Commotari/vic2020_V2/vic2020mainboard/Address_Selection.kicad_sch

## KiCad design vic2020mainboard/Address_Selection.kicad_sch (2026-04-03)

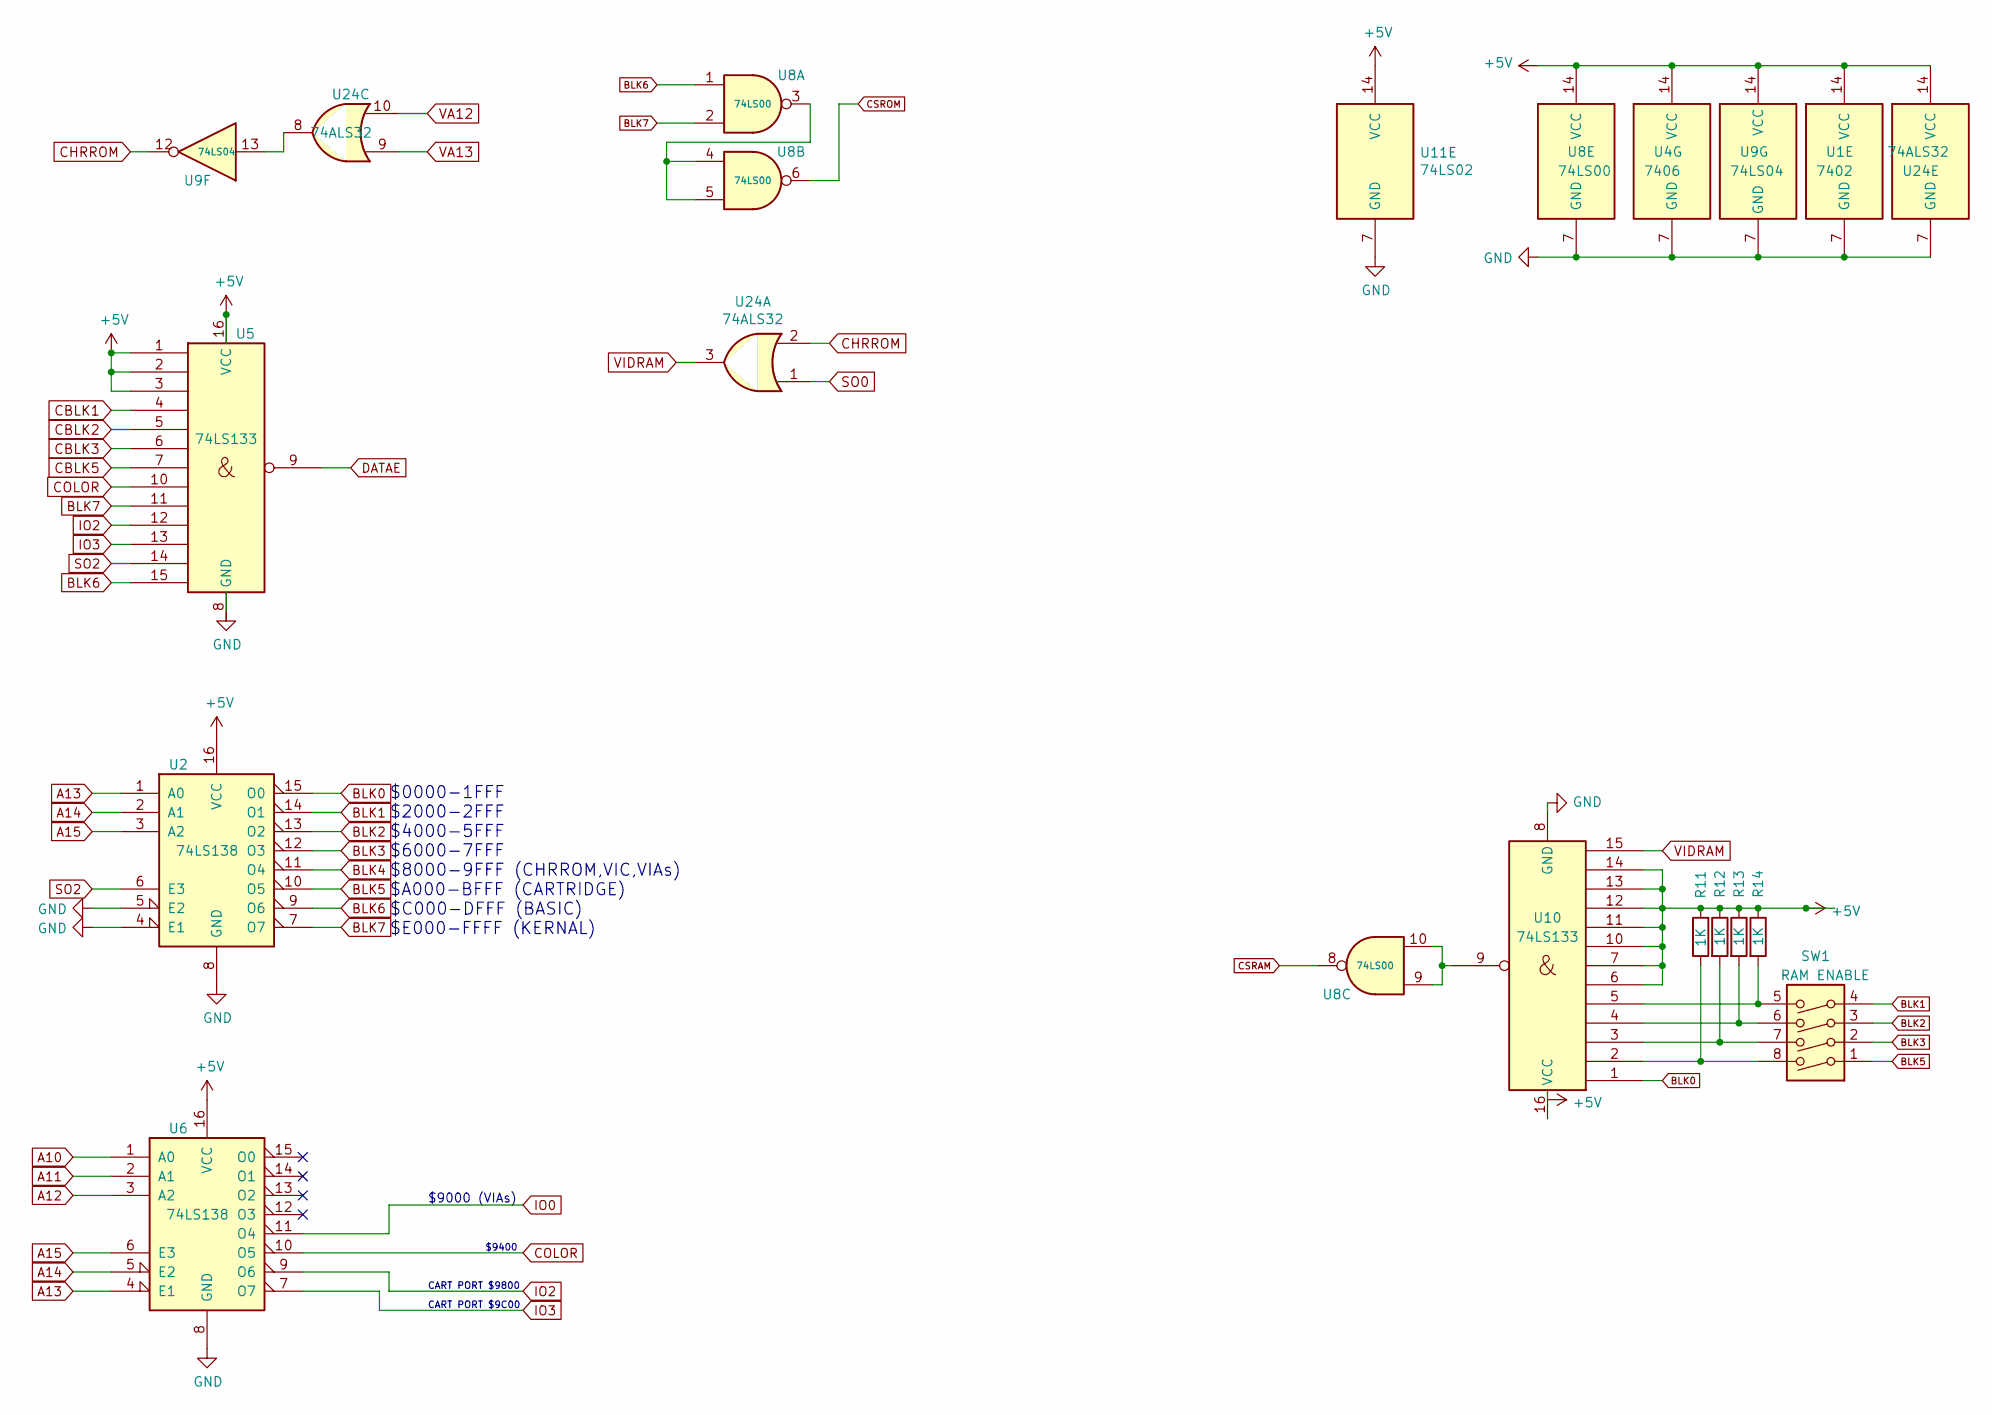
[picture p1: schematic Address_Selection.kicad_sch]

Parts:
R11, R12, R13, R14: 1K; R_Axial_DIN0207_L6.3mm_D2.5mm_P7.62mm_Horizontal
SW1: RAM ENABLE; DIP-8_W7.62mm
U1: 7402; DIP-14_W7.62mm_Socket
U2, U6: 74LS138; DIP-16_W7.62mm_Socket
U4: 7406; DIP-14_W7.62mm_Socket
U5, U10: 74LS133; DIP-16_W7.62mm_Socket
U8: 74LS00; DIP-14_W7.62mm_Socket
U9: 74LS04; DIP-14_W7.62mm_Socket
U11: 74LS02; DIP-14_W7.62mm_Socket
U24: 74ALS32; DIP-14_W7.62mm_Socket

Connections:
+5V: R11.2, R12.1, R13.1, R14.1, U1.14 (VCC), U2.16 (VCC), U4.14 (VCC), U5.1, U5.2, U5.3, U5.16 (VCC), U6.16 (VCC), U8.14 (VCC), U9.14 (VCC), U10.6, U10.7, U10.10, U10.11, U10.12, U10.13, U10.14, U11.14 (VCC), U24.14 (VCC)
A10: U6.1 (A0)
A11: U6.2 (A1)
A12: U6.3 (A2)
A13: U2.1 (A0), U6.4 (E1)
A14: U2.2 (A1), U6.5 (E2)
A15: U2.3 (A2), U6.6 (E3)
BLK0: U2.15 (O0), U10.1
BLK1: SW1.4, U2.14 (O1)
BLK2: SW1.3, U2.13 (O2)
BLK3: SW1.2, U2.12 (O3)
BLK4: U2.11 (O4)
BLK5: SW1.1, U2.10 (O5)
BLK6: U2.9 (O6), U5.15, U8.1
BLK7: U2.7 (O7), U5.11, U8.2
CBLK1: U5.4
CBLK2: U5.5
CBLK3: U5.6
CBLK5: U5.7
CHRROM: U9.12, U24.2
COLOR: U5.10, U6.10 (O5)
CSRAM: U8.8
CSROM: U8.6
DATAE: U5.9
GND: U1.7 (GND), U2.4 (E1), U2.5 (E2), U2.8 (GND), U4.7 (GND), U6.8 (GND), U8.7 (GND), U9.7 (GND), U10.8 (GND), U11.7 (GND), U24.7 (GND)
IO0: U6.11 (O4)
IO2: U5.12, U6.9 (O6)
IO3: U5.13, U6.7 (O7)
unnamed: R11.1, SW1.8, U10.2
unnamed: R12.2, SW1.7, U10.3
unnamed: R13.2, SW1.6, U10.4
unnamed: R14.2, SW1.5, U10.5
unnamed: U8.3, U8.4, U8.5
unnamed: U8.9, U8.10, U10.9
unnamed: U9.13, U24.8
SO0: U24.1
SO2: U2.6 (E3), U5.14
VA12: U24.10
VA13: U24.9
VIDRAM: U10.15, U24.3

Notes on the sheet:
$0000-1FFF $2000-2FFF $4000-5FFF $6000-7FFF $8000-9FFF (CHRROM,VIC,VIAs) $A000-BFFF (CARTRIDGE) $C000-DFFF (BASIC) $E000-FFFF (KERNAL)
CART PORT $9800
CART PORT $9C00
$9400
$9000 (VIAs)
