Commotari/vic2020_V2/vic2020mainboard/Memory.kicad_sch

## KiCad design vic2020mainboard/Memory.kicad_sch (2026-04-03)

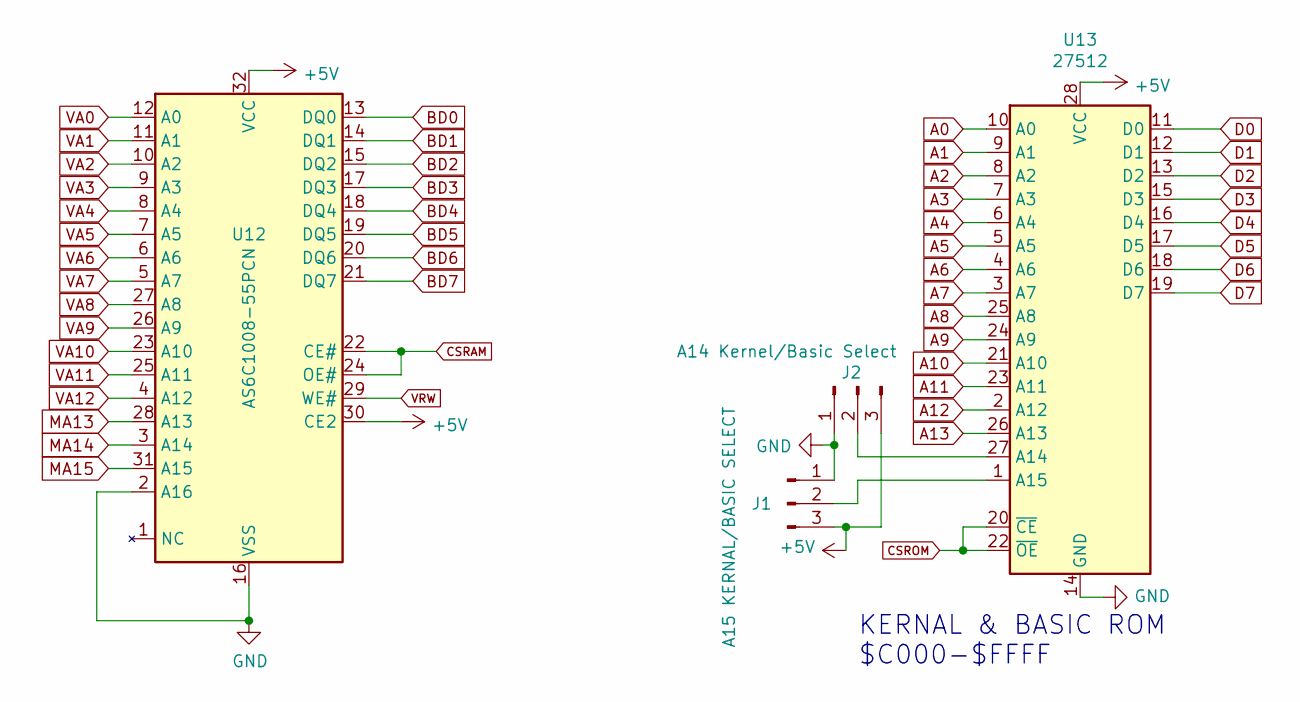
[picture p2: schematic Memory.kicad_sch]

Parts:
J1: A15 KERNAL/BASIC SELECT; PinHeader_1x03_P2.54mm_Vertical
J2: A14 Kernel/Basic Select; PinHeader_1x03_P2.54mm_Vertical
U12: AS6C1008-55PCN; DIP-32_W15.24mm
U13: 27512; DIP-28_W15.24mm

Connections:
+5V: J1.3, J2.3, U12.30 (CE2), U12.32 (VCC), U13.28 (VCC)
A0: U13.10 (A0)
A1: U13.9 (A1)
A2: U13.8 (A2)
A3: U13.7 (A3)
A4: U13.6 (A4)
A5: U13.5 (A5)
A6: U13.4 (A6)
A7: U13.3 (A7)
A8: U13.25 (A8)
A9: U13.24 (A9)
A10: U13.21 (A10)
A11: U13.23 (A11)
A12: U13.2 (A12)
A13: U13.26 (A13)
BD0: U12.13 (DQ0)
BD1: U12.14 (DQ1)
BD2: U12.15 (DQ2)
BD3: U12.17 (DQ3)
BD4: U12.18 (DQ4)
BD5: U12.19 (DQ5)
BD6: U12.20 (DQ6)
BD7: U12.21 (DQ7)
CSRAM: U12.22 (CE#), U12.24 (OE#)
CSROM: U13.20 (~CE), U13.22 (~OE)
D0: U13.11 (D0)
D1: U13.12 (D1)
D2: U13.13 (D2)
D3: U13.15 (D3)
D4: U13.16 (D4)
D5: U13.17 (D5)
D6: U13.18 (D6)
D7: U13.19 (D7)
GND: J1.1, J2.1, U12.2 (A16), U12.16 (VSS), U13.14 (GND)
MA13: U12.28 (A13)
MA14: U12.3 (A14)
MA15: U12.31 (A15)
unnamed: J1.2, U13.1 (A15)
unnamed: J2.2, U13.27 (A14)
VA0: U12.12 (A0)
VA1: U12.11 (A1)
VA2: U12.10 (A2)
VA3: U12.9 (A3)
VA4: U12.8 (A4)
VA5: U12.7 (A5)
VA6: U12.6 (A6)
VA7: U12.5 (A7)
VA8: U12.27 (A8)
VA9: U12.26 (A9)
VA10: U12.23 (A10)
VA11: U12.25 (A11)
VA12: U12.4 (A12)
VRW: U12.29 (WE#)

Notes on the sheet:
KERNAL & BASIC ROM $C000-$FFFF
