Commotari/vic2020_V2/vic2020mainboard/Power_Supply.kicad_sch

## KiCad design vic2020mainboard/Power_Supply.kicad_sch (2026-04-03)

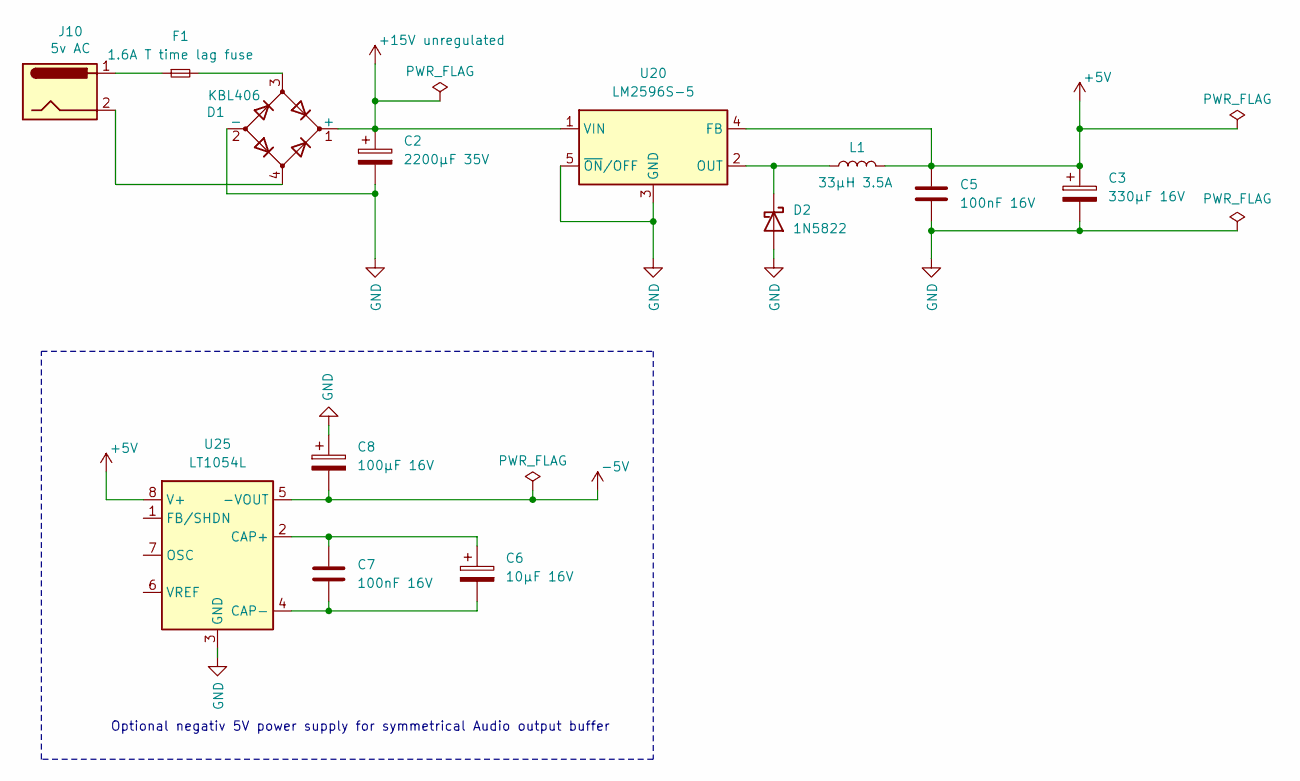
[picture p3: schematic Power_Supply.kicad_sch]

Parts:
C2: 2200µF 35V
C3: 330µF 16V
C5, C7: 100nF 16V
C6: 10µF 16V
C8: 100µF 16V
D1: KBL406
D2: 1N5822
F1: 1.6A T time lag fuse
J10: 5v AC; BarrelJack_CUI_PJ-063AH_Horizontal
L1: 33µH 3.5A
U20: LM2596S-5; TO-263-5_TabPin3
U25: LT1054L

Connections:
+5V: C3.1, C5.1, L1.2, U20.4 (FB), U25.8 (V+)
+15V unregulated: C2.1, D1.1 (+), U20.1 (VIN)
-5V: C8.2, U25.5 (-VOUT)
GND: C2.2, C3.2, C5.2, C8.1, D1.2 (-), D2.2 (A), U20.3 (GND), U20.5 (~ON/OFF), U25.3 (GND)
unnamed: C6.1, C7.1, U25.2 (CAP+)
unnamed: C6.2, C7.2, U25.4 (CAP-)
unnamed: D1.3, F1.2
unnamed: D1.4, J10.2
unnamed: D2.1 (K), L1.1, U20.2 (OUT)
unnamed: F1.1, J10.1

Notes on the sheet:
Optional negativ 5V power supply for symmetrical Audio output buffer
