Commotari/vic2020_V2/vic2020mainboard/VIC2020DISPLAY.kicad_sch

## KiCad design vic2020mainboard/VIC2020DISPLAY.kicad_sch (2026-04-03)

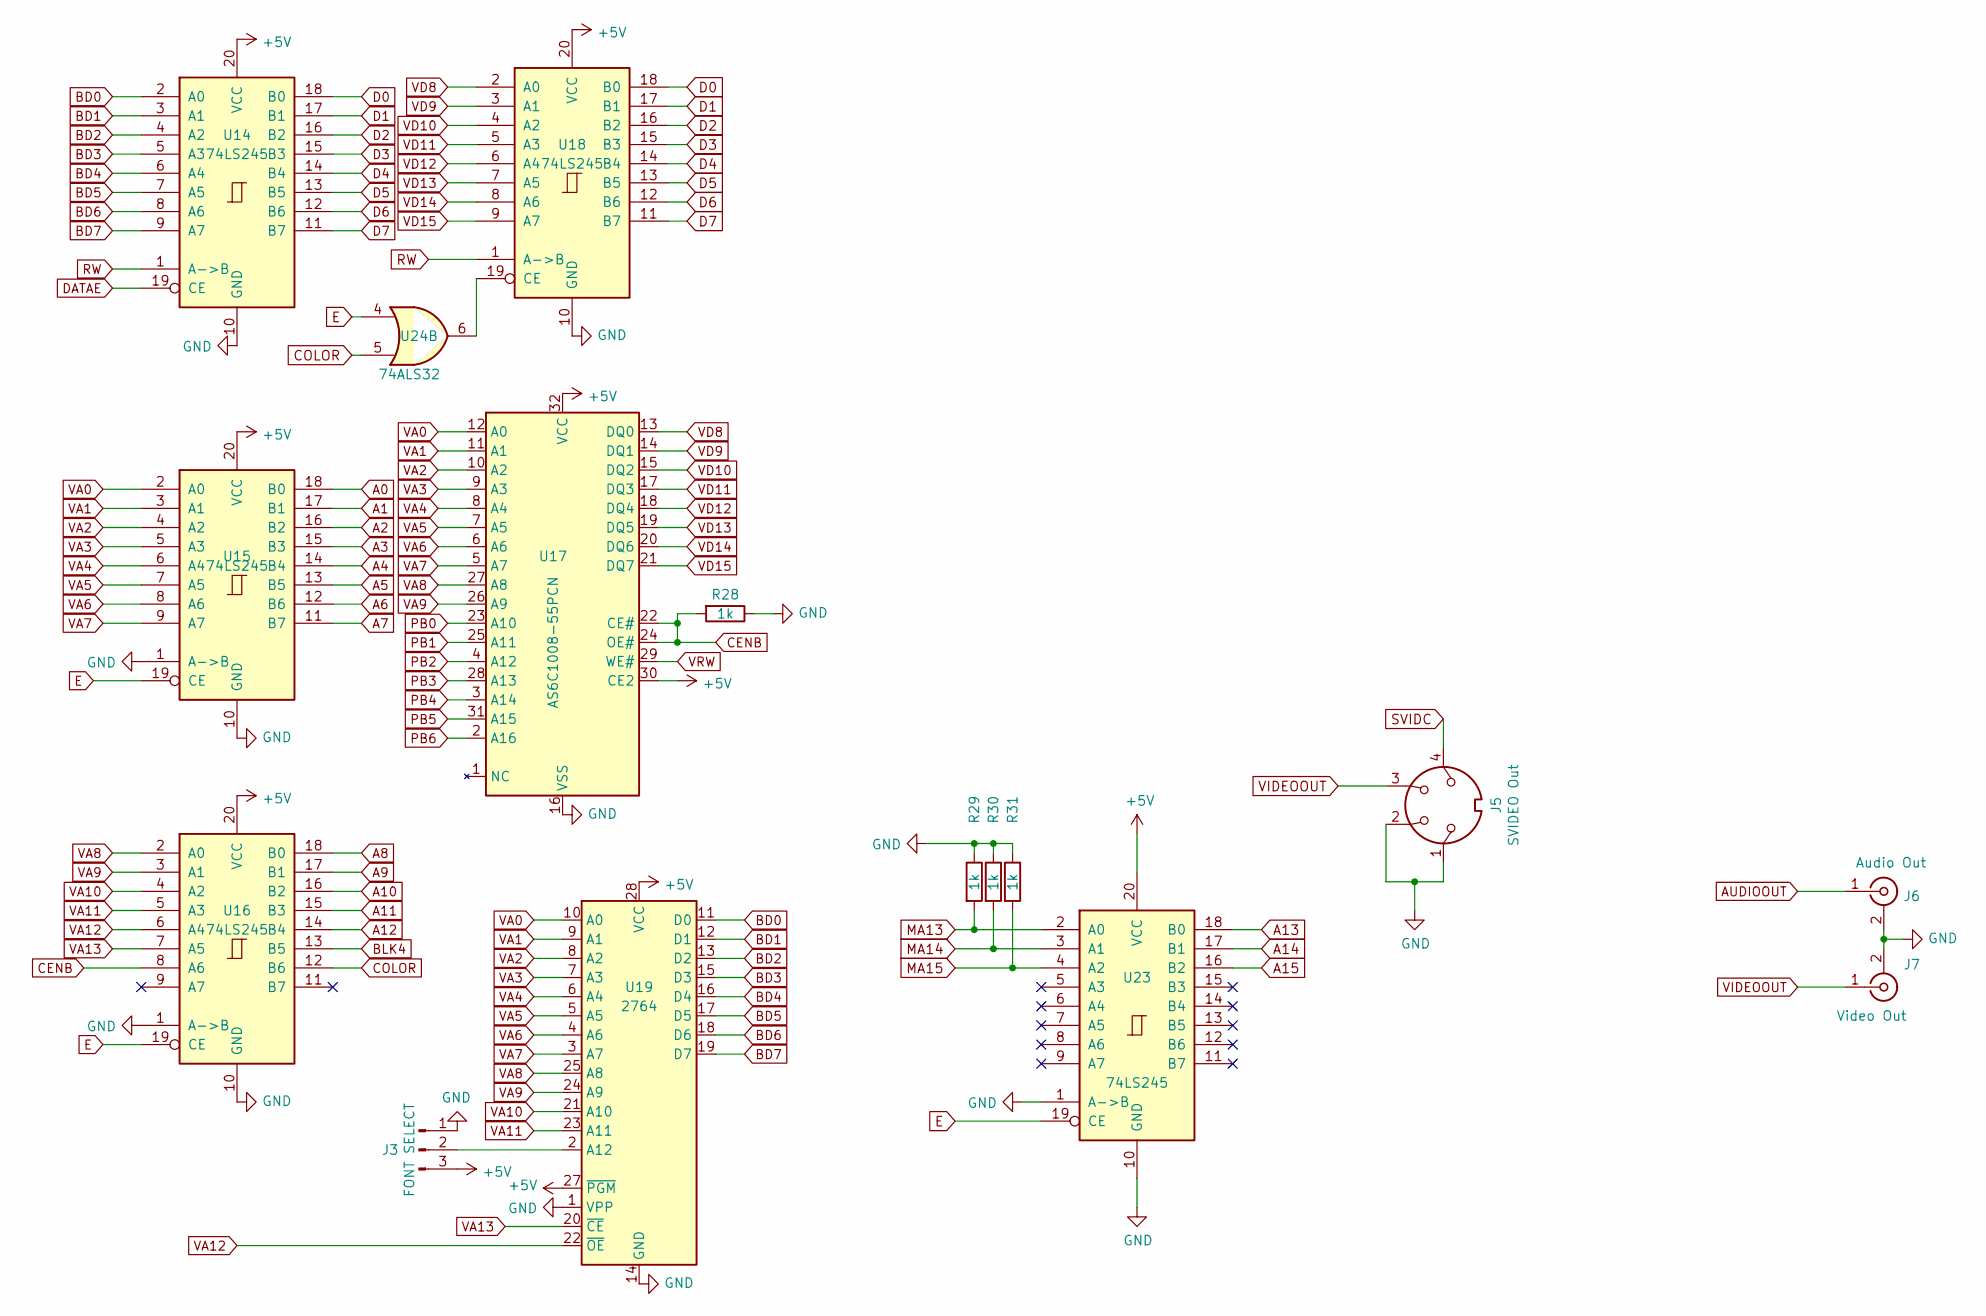
[picture p4: schematic VIC2020DISPLAY.kicad_sch]

Parts:
J3: FONT SELECT; PinHeader_1x03_P2.54mm_Vertical
J5: SVIDEO Out; DIN-4TE_5749181-1
J6: Audio Out; CUI_RCJ-041-reversepins
J7: Video Out; CUI_RCJ-041-reversepins
R28, R29, R30, R31: 1k; R_Axial_DIN0207_L6.3mm_D2.5mm_P7.62mm_Horizontal
U14, U15, U16, U18, U23: 74LS245; DIP-20_W7.62mm_Socket
U17: AS6C1008-55PCN; DIP-32_W15.24mm
U19: 2764; DIP-28_W15.24mm_Socket
U24: 74ALS32; DIP-14_W7.62mm_Socket

Connections:
+5V: J3.3, U14.20 (VCC), U15.20 (VCC), U16.20 (VCC), U17.30 (CE2), U17.32 (VCC), U18.20 (VCC), U19.27 (~PGM), U19.28 (VCC), U23.20 (VCC)
A0: U15.18 (B0)
A1: U15.17 (B1)
A2: U15.16 (B2)
A3: U15.15 (B3)
A4: U15.14 (B4)
A5: U15.13 (B5)
A6: U15.12 (B6)
A7: U15.11 (B7)
A8: U16.18 (B0)
A9: U16.17 (B1)
A10: U16.16 (B2)
A11: U16.15 (B3)
A12: U16.14 (B4)
A13: U23.18 (B0)
A14: U23.17 (B1)
A15: U23.16 (B2)
AUDIOOUT: J6.1 (In)
BD0: U14.2 (A0), U19.11 (D0)
BD1: U14.3 (A1), U19.12 (D1)
BD2: U14.4 (A2), U19.13 (D2)
BD3: U14.5 (A3), U19.15 (D3)
BD4: U14.6 (A4), U19.16 (D4)
BD5: U14.7 (A5), U19.17 (D5)
BD6: U14.8 (A6), U19.18 (D6)
BD7: U14.9 (A7), U19.19 (D7)
BLK4: U16.13 (B5)
CENB: R28.2, U16.8 (A6), U17.22 (CE#), U17.24 (OE#)
COLOR: U16.12 (B6), U24.5
D0: U14.18 (B0), U18.18 (B0)
D1: U14.17 (B1), U18.17 (B1)
D2: U14.16 (B2), U18.16 (B2)
D3: U14.15 (B3), U18.15 (B3)
D4: U14.14 (B4), U18.14 (B4)
D5: U14.13 (B5), U18.13 (B5)
D6: U14.12 (B6), U18.12 (B6)
D7: U14.11 (B7), U18.11 (B7)
DATAE: U14.19 (CE)
E: U15.19 (CE), U16.19 (CE), U23.19 (CE), U24.4
GND: J3.1, J5.1, J5.2, J6.2 (Ext), J7.2 (Ext), R28.1, R29.1, R30.1, R31.1, U14.10 (GND), U15.1 (A->B), U15.10 (GND), U16.1 (A->B), U16.10 (GND), U17.16 (VSS), U18.10 (GND), U19.1 (VPP), U19.14 (GND), U23.1 (A->B), U23.10 (GND)
MA13: R29.2, U23.2 (A0)
MA14: R30.2, U23.3 (A1)
MA15: R31.2, U23.4 (A2)
unnamed: J3.2, U19.2 (A12)
unnamed: U18.19 (CE), U24.6
PB0: U17.23 (A10)
PB1: U17.25 (A11)
PB2: U17.4 (A12)
PB3: U17.28 (A13)
PB4: U17.3 (A14)
PB5: U17.31 (A15)
PB6: U17.2 (A16)
RW: U14.1 (A->B), U18.1 (A->B)
SVIDC: J5.4
VA0: U15.2 (A0), U17.12 (A0), U19.10 (A0)
VA1: U15.3 (A1), U17.11 (A1), U19.9 (A1)
VA2: U15.4 (A2), U17.10 (A2), U19.8 (A2)
VA3: U15.5 (A3), U17.9 (A3), U19.7 (A3)
VA4: U15.6 (A4), U17.8 (A4), U19.6 (A4)
VA5: U15.7 (A5), U17.7 (A5), U19.5 (A5)
VA6: U15.8 (A6), U17.6 (A6), U19.4 (A6)
VA7: U15.9 (A7), U17.5 (A7), U19.3 (A7)
VA8: U16.2 (A0), U17.27 (A8), U19.25 (A8)
VA9: U16.3 (A1), U17.26 (A9), U19.24 (A9)
VA10: U16.4 (A2), U19.21 (A10)
VA11: U16.5 (A3), U19.23 (A11)
VA12: U16.6 (A4), U19.22 (~OE)
VA13: U16.7 (A5), U19.20 (~CE)
VD8: U17.13 (DQ0), U18.2 (A0)
VD9: U17.14 (DQ1), U18.3 (A1)
VD10: U17.15 (DQ2), U18.4 (A2)
VD11: U17.17 (DQ3), U18.5 (A3)
VD12: U17.18 (DQ4), U18.6 (A4)
VD13: U17.19 (DQ5), U18.7 (A5)
VD14: U17.20 (DQ6), U18.8 (A6)
VD15: U17.21 (DQ7), U18.9 (A7)
VIDEOOUT: J5.3, J7.1 (In)
VRW: U17.29 (WE#)
