Commotari/vic2020_V2/vic2020mainboard/VIC2020IO.kicad_sch

## KiCad design vic2020mainboard/VIC2020IO.kicad_sch (2026-04-03)

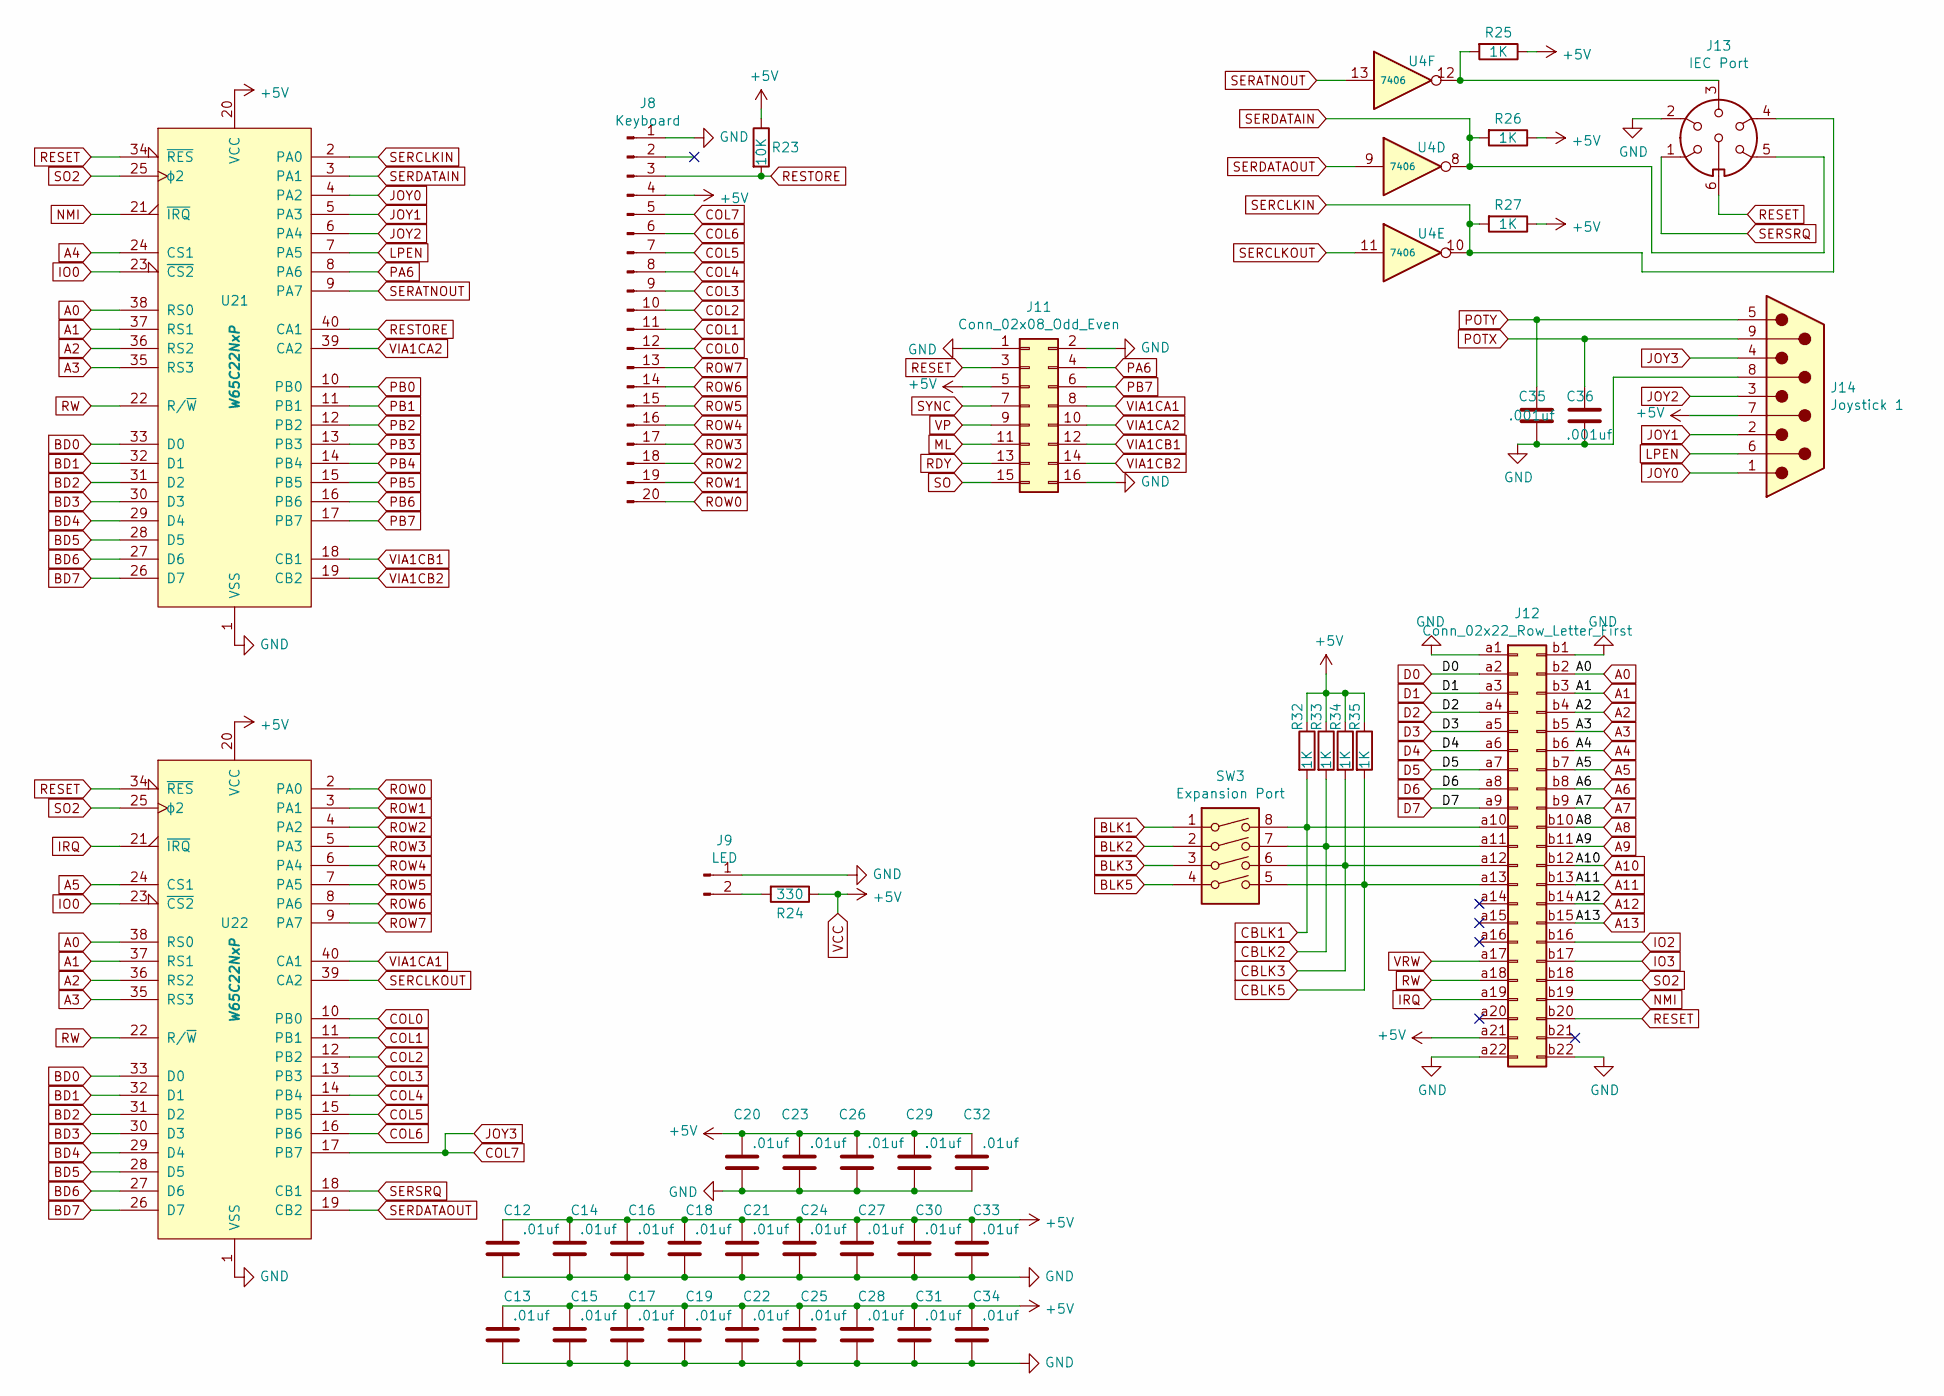
[picture p5: schematic VIC2020IO.kicad_sch]

Parts:
C12, C13, C14, C15, C16, C17, C18, C19, C20, C21, C22, C23, C24, C25, C26, C27, C28, C29, C30, C31, C32, C33, C34: .01uf; C_Rect_L7.0mm_W2.0mm_P5.00mm
C35, C36: .001uf; C_Rect_L7.0mm_W2.0mm_P5.00mm
J8: Keyboard; PinHeader_1x20_P2.54mm_Vertical
J9: LED; PinHeader_1x02_P2.54mm_Vertical
J11: Conn_02x08_Odd_Even; PinHeader_2x08_P2.54mm_Vertical
J12: Conn_02x22_Row_Letter_First; vic20cartridge1
J13: IEC Port; din6
J14: Joystick 1; DSUB-9_Male_Horizontal_P2.77x2.84mm_EdgePinOffset4.94mm_Hou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
R23: 10K; R_Axial_DIN0207_L6.3mm_D2.5mm_P7.62mm_Horizontal
R24: 330; R_Axial_DIN0207_L6.3mm_D2.5mm_P7.62mm_Horizontal
R25, R26, R27, R32, R33, R34, R35: 1K; R_Axial_DIN0207_L6.3mm_D2.5mm_P7.62mm_Horizontal
SW3: Expansion Port; DIP-8_W7.62mm
U4: 7406; DIP-14_W7.62mm_Socket
U21, U22: W65C22NxP; DIP-40_W15.24mm_Socket

Connections:
+5V: C12.1, C13.1, C14.1, C15.1, C16.1, C17.1, C18.1, C19.1, C20.1, C21.1, C22.1, C23.1, C24.1, C25.1, C26.1, C27.1, C28.1, C29.1, C30.1, C31.1, C32.1, C33.1, C34.1, J8.4, J11.5, J12.a21, J14.7, R23.1, R24.1, R25.1, R26.1, R27.1, R32.1, R33.1, R34.1, R35.1, U21.20 (VCC), U22.20 (VCC)
A0: J12.b2, U21.38 (RS0), U22.38 (RS0)
A1: J12.b3, U21.37 (RS1), U22.37 (RS1)
A2: J12.b4, U21.36 (RS2), U22.36 (RS2)
A3: J12.b5, U21.35 (RS3), U22.35 (RS3)
A4: J12.b6, U21.24 (CS1)
A5: J12.b7, U22.24 (CS1)
A6: J12.b8
A7: J12.b9
A8: J12.b10
A9: J12.b11
A10: J12.b12
A11: J12.b13
A12: J12.b14
A13: J12.b15
BD0: U21.33 (D0), U22.33 (D0)
BD1: U21.32 (D1), U22.32 (D1)
BD2: U21.31 (D2), U22.31 (D2)
BD3: U21.30 (D3), U22.30 (D3)
BD4: U21.29 (D4), U22.29 (D4)
BD5: U21.28 (D5), U22.28 (D5)
BD6: U21.27 (D6), U22.27 (D6)
BD7: U21.26 (D7), U22.26 (D7)
BLK1: SW3.1
BLK2: SW3.2
BLK3: SW3.3
BLK5: SW3.4
CBLK1: J12.a10, R32.2, SW3.8
CBLK2: J12.a11, R33.2, SW3.7
CBLK3: J12.a12, R34.2, SW3.6
CBLK5: J12.a13, R35.2, SW3.5
COL0: J8.12, U22.10 (PB0)
COL1: J8.11, U22.11 (PB1)
COL2: J8.10, U22.12 (PB2)
COL3: J8.9, U22.13 (PB3)
COL4: J8.8, U22.14 (PB4)
COL5: J8.7, U22.15 (PB5)
COL6: J8.6, U22.16 (PB6)
COL7: J8.5, J14.4, U22.17 (PB7)
D0: J12.a2
D1: J12.a3
D2: J12.a4
D3: J12.a5
D4: J12.a6
D5: J12.a7
D6: J12.a8
D7: J12.a9
GND: C12.2, C13.2, C14.2, C15.2, C16.2, C17.2, C18.2, C19.2, C20.2, C21.2, C22.2, C23.2, C24.2, C25.2, C26.2, C27.2, C28.2, C29.2, C30.2, C31.2, C32.2, C33.2, C34.2, C35.2, C36.2, J8.1, J9.1, J11.1, J11.2, J11.16, J12.a1, J12.a22, J12.b1, J12.b22, J13.2, J14.8, U21.1 (VSS), U22.1 (VSS)
IO0: U21.23 (~CS2), U22.23 (~CS2)
IO2: J12.b16
IO3: J12.b17
IRQ: J12.a19, U22.21 (~IRQ)
JOY0: J14.1, U21.4 (PA2)
JOY1: J14.2, U21.5 (PA3)
JOY2: J14.3, U21.6 (PA4)
LPEN: J14.6, U21.7 (PA5)
ML: J11.11
NMI: J12.b19, U21.21 (~IRQ)
unnamed: J9.2, R24.2
unnamed: J13.3, R25.2, U4.12
PA6: J11.4, U21.8 (PA6)
PB0: U21.10 (PB0)
PB1: U21.11 (PB1)
PB2: U21.12 (PB2)
PB3: U21.13 (PB3)
PB4: U21.14 (PB4)
PB5: U21.15 (PB5)
PB6: U21.16 (PB6)
PB7: J11.6, U21.17 (PB7)
POTX: C36.1, J14.9
POTY: C35.1, J14.5
RDY: J11.13
RESET: J11.3, J12.b20, J13.6, U21.34 (~RES), U22.34 (~RES)
RESTORE: J8.3, R23.2, U21.40 (CA1)
ROW0: J8.20, U22.2 (PA0)
ROW1: J8.19, U22.3 (PA1)
ROW2: J8.18, U22.4 (PA2)
ROW3: J8.17, U22.5 (PA3)
ROW4: J8.16, U22.6 (PA4)
ROW5: J8.15, U22.7 (PA5)
ROW6: J8.14, U22.8 (PA6)
ROW7: J8.13, U22.9 (PA7)
RW: J12.a18, U21.22 (R/~W), U22.22 (R/~W)
SERATNOUT: U4.13, U21.9 (PA7)
SERCLKIN: J13.4, R27.2, U4.10, U21.2 (PA0)
SERCLKOUT: U4.11, U22.39 (CA2)
SERDATAIN: J13.5, R26.2, U4.8, U21.3 (PA1)
SERDATAOUT: U4.9, U22.19 (CB2)
SERSRQ: J13.1, U22.18 (CB1)
SO: J11.15
SO2: J12.b18, U21.25 (ϕ2), U22.25 (ϕ2)
SYNC: J11.7
VIA1CA1: J11.8, U22.40 (CA1)
VIA1CA2: J11.10, U21.39 (CA2)
VIA1CB1: J11.12, U21.18 (CB1)
VIA1CB2: J11.14, U21.19 (CB2)
VP: J11.9
VRW: J12.a17
