Commotari/vic2020_V2/vic2020mainboard/Vic2020mainboard.kicad_sch

## KiCad design vic2020mainboard/Vic2020mainboard.kicad_sch (2026-04-03)

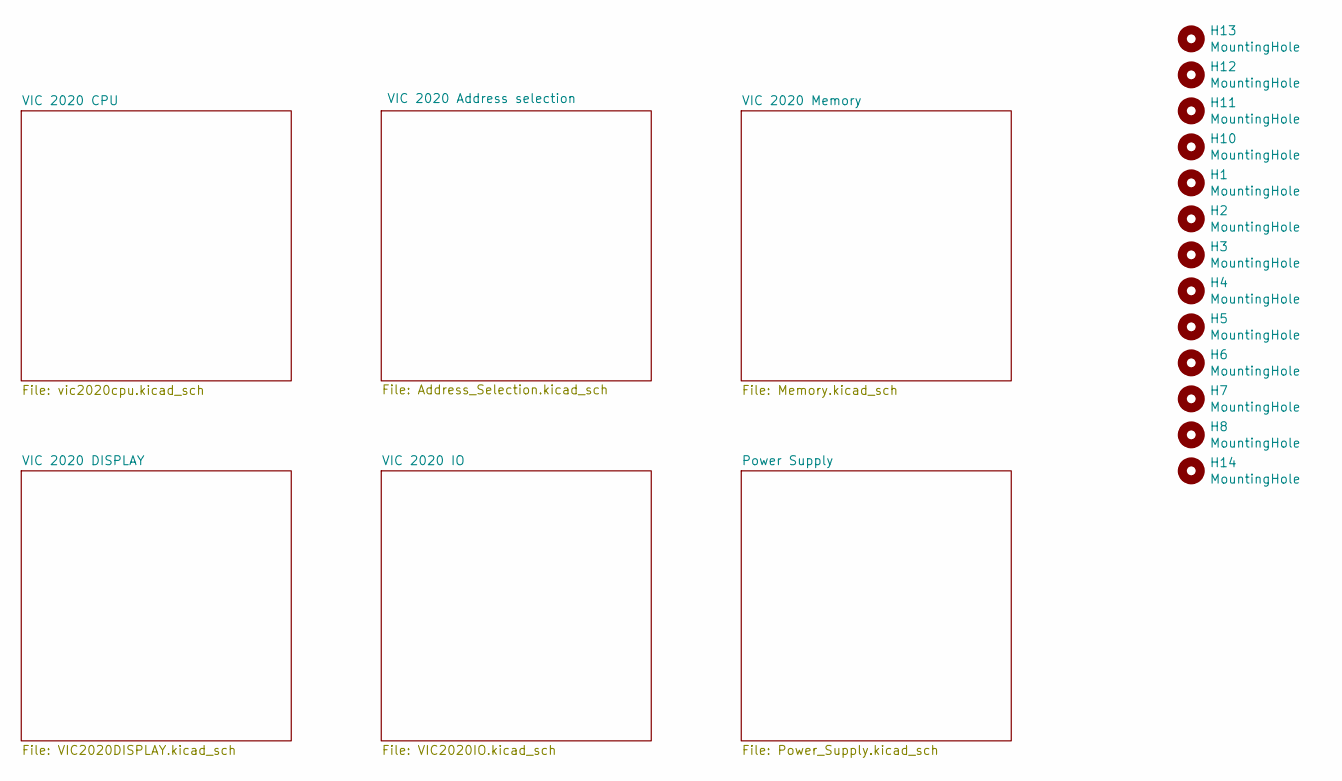
[picture p6: schematic Vic2020mainboard.kicad_sch]

Parts:
H1, H2, H3, H4, H5, H6, H7, H8, H10, H11, H12, H13, H14: MountingHole; MountingHole_3.2mm_M3_Pad
