Commotari/vic2020_V2/vic2020mainboard/vic2020cpu.kicad_sch

## KiCad design vic2020mainboard/vic2020cpu.kicad_sch (2026-04-03)

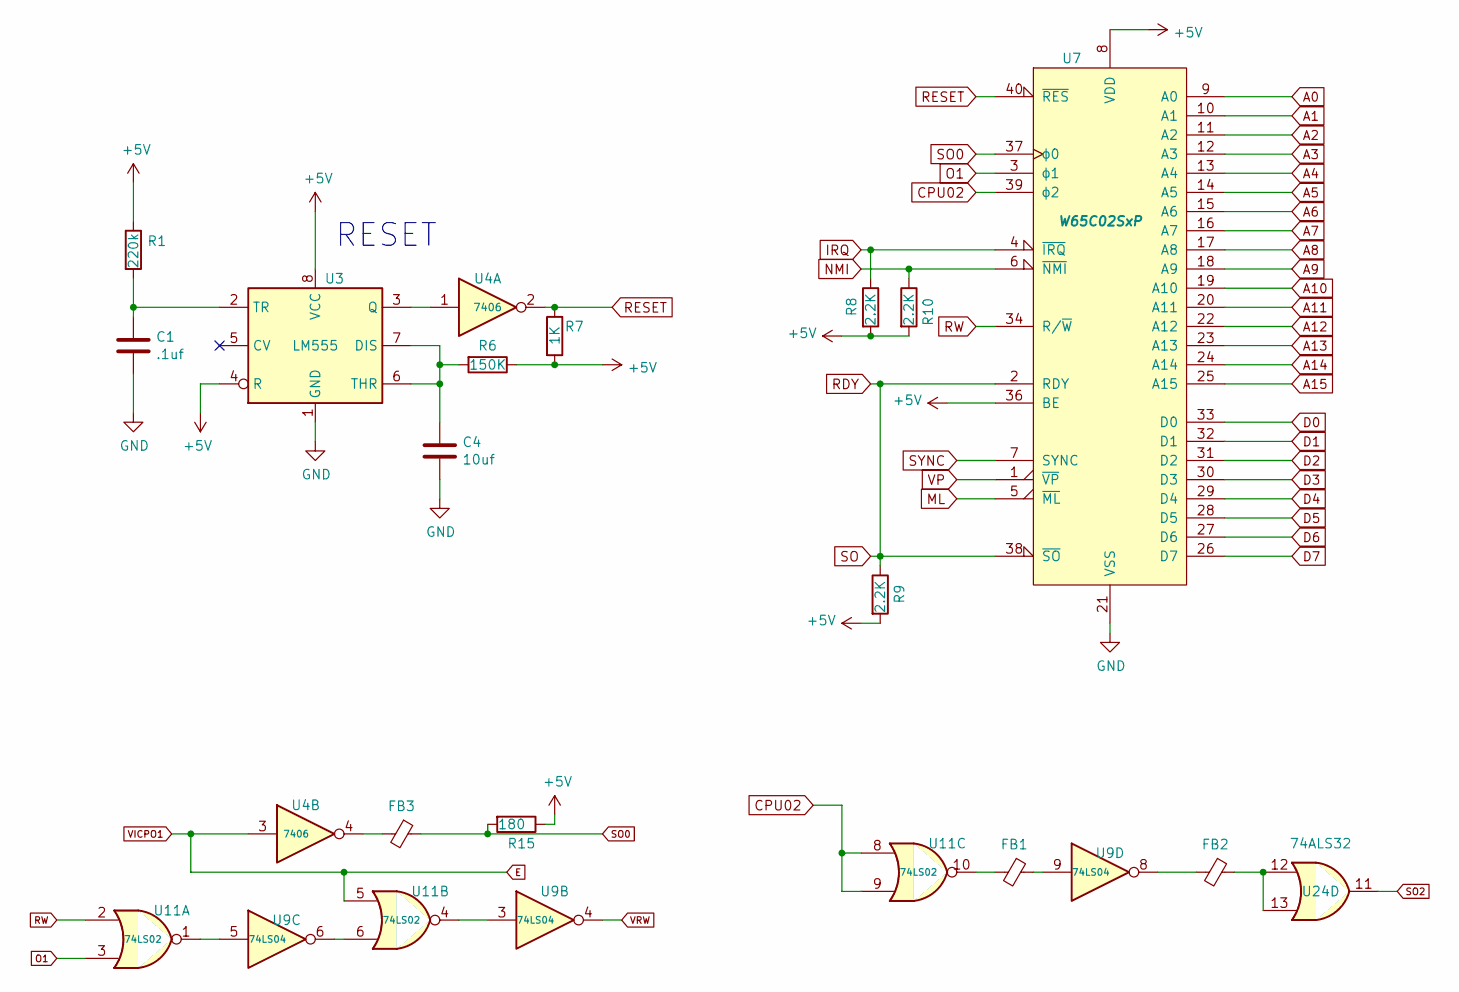
[picture p7: schematic vic2020cpu.kicad_sch]

Parts:
C1: .1uf; C_Rect_L7.0mm_W2.0mm_P5.00mm
C4: 10uf; CP_Radial_D4.0mm_P2.00mm
FB1, FB2, FB3: Ferrite_Bead_Small; L_Axial_L6.6mm_D2.7mm_P10.16mm_Horizontal_Vishay_IM-2
R1: 220k; R_Axial_DIN0207_L6.3mm_D2.5mm_P7.62mm_Horizontal
R6: 150K; R_Axial_DIN0207_L6.3mm_D2.5mm_P7.62mm_Horizontal
R7: 1K; R_Axial_DIN0207_L6.3mm_D2.5mm_P7.62mm_Horizontal
R8, R9, R10: 2.2K; R_Axial_DIN0207_L6.3mm_D2.5mm_P7.62mm_Horizontal
R15: 180; R_Axial_DIN0207_L6.3mm_D2.5mm_P7.62mm_Horizontal
U3: LM555; DIP-8_W7.62mm_Socket
U4: 7406; DIP-14_W7.62mm_Socket
U7: W65C02SxP; DIP-40_W15.24mm_Socket
U9: 74LS04; DIP-14_W7.62mm_Socket
U11: 74LS02; DIP-14_W7.62mm_Socket
U24: 74ALS32; DIP-14_W7.62mm_Socket

Connections:
+5V: R1.1, R6.1, R7.2, R8.2, R9.2, R10.2, R15.1, U3.4 (R), U3.8 (VCC), U7.8 (VDD), U7.36 (BE)
A0: U7.9 (A0)
A1: U7.10 (A1)
A2: U7.11 (A2)
A3: U7.12 (A3)
A4: U7.13 (A4)
A5: U7.14 (A5)
A6: U7.15 (A6)
A7: U7.16 (A7)
A8: U7.17 (A8)
A9: U7.18 (A9)
A10: U7.19 (A10)
A11: U7.20 (A11)
A12: U7.22 (A12)
A13: U7.23 (A13)
A14: U7.24 (A14)
A15: U7.25 (A15)
CPU02: U7.39 (ϕ2), U11.8, U11.9
D0: U7.33 (D0)
D1: U7.32 (D1)
D2: U7.31 (D2)
D3: U7.30 (D3)
D4: U7.29 (D4)
D5: U7.28 (D5)
D6: U7.27 (D6)
D7: U7.26 (D7)
E: U4.3, U11.5
GND: C1.2, C4.2, U3.1 (GND), U7.21 (VSS)
IRQ: R8.1, U7.4 (~IRQ)
ML: U7.5 (~ML)
NMI: R10.1, U7.6 (~NMI)
unnamed: C1.1, R1.2, U3.2 (TR)
unnamed: C4.1, R6.2, U3.6 (THR), U3.7 (DIS)
unnamed: FB1.1, U9.9
unnamed: FB1.2, U11.10
unnamed: FB2.1, U24.12, U24.13
unnamed: FB2.2, U9.8
unnamed: FB3.2, U4.4
unnamed: U3.3 (Q), U4.1
unnamed: U9.5, U11.1
unnamed: U9.3, U11.4
unnamed: U9.6, U11.6
O1: U7.3 (ϕ1), U11.3
RDY: R9.1, U7.2 (RDY), U7.38 (~SO)
RESET: R7.1, U4.2, U7.40 (~RES)
RW: U7.34 (R/~W), U11.2
SO0: FB3.1, R15.2, U7.37 (ϕ0)
SO2: U24.11
SYNC: U7.7 (SYNC)
VP: U7.1 (~VP)
VRW: U9.4

Notes on the sheet:
RESET
