Commotari/vic2020_V2/vic2020mainboard/video_daughter_board_ntsc.kicad_sch

## KiCad design vic2020mainboard/video_daughter_board_ntsc.kicad_sch (2026-04-03)

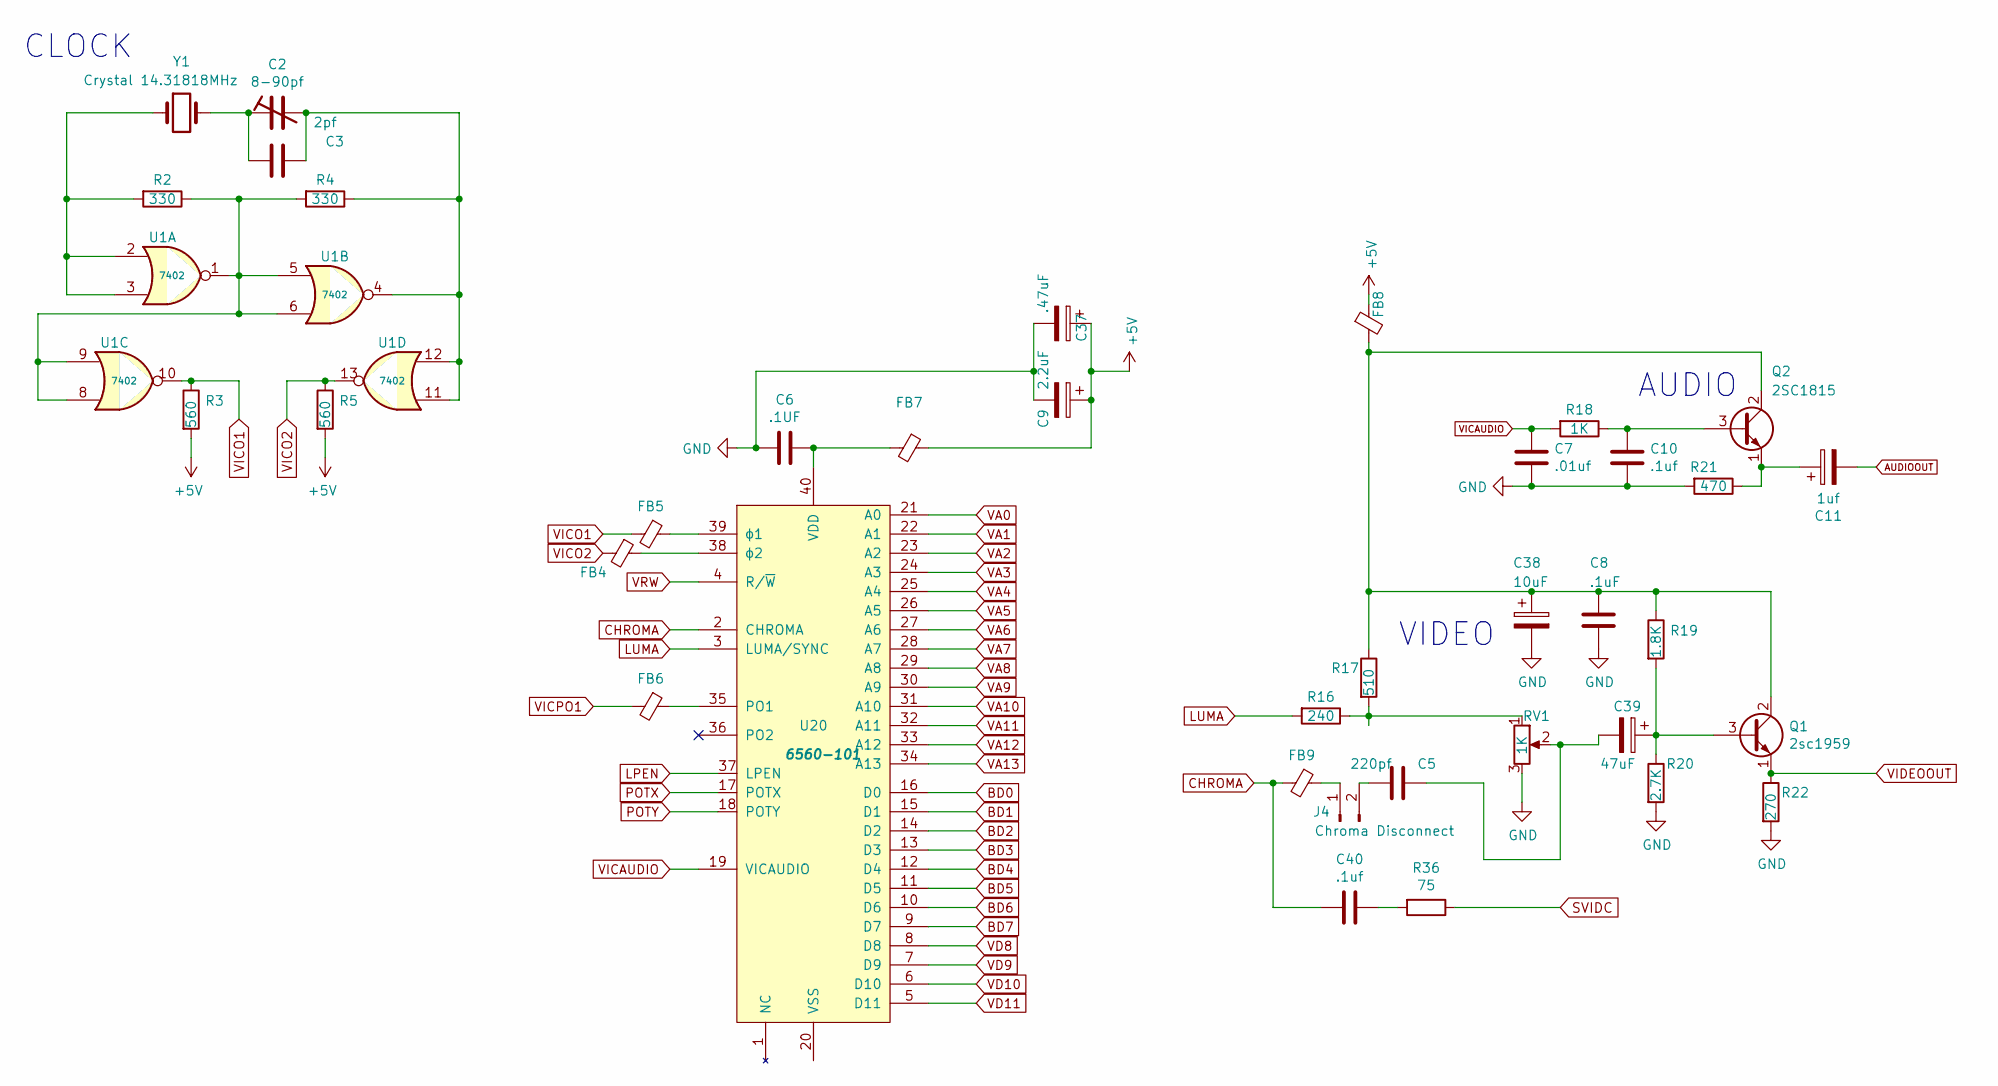
[picture p8: schematic video_daughter_board_ntsc.kicad_sch]

Parts:
C2: 8-90pf; C_Radial_D10.0mm_H12.5mm_P5.00mm
C3: 2pf; C_Rect_L7.0mm_W2.0mm_P5.00mm
C5: 220pf; C_Rect_L7.0mm_W2.0mm_P5.00mm
C6: .1UF; C_Rect_L7.0mm_W2.0mm_P5.00mm
C7: .01uf; C_Rect_L7.0mm_W2.0mm_P5.00mm
C8: .1uF; C_Rect_L7.0mm_W2.0mm_P5.00mm
C9: 2.2uF; CP_Radial_D4.0mm_P2.00mm
C10, C40: .1uf; C_Rect_L7.0mm_W2.0mm_P5.00mm
C11: 1uf; CP_Radial_D4.0mm_P2.00mm
C37: .47uF; CP_Radial_D4.0mm_P2.00mm
C38: 10uF; CP_Radial_D4.0mm_P2.00mm
C39: 47uF; CP_Radial_D4.0mm_P2.00mm
FB4, FB5, FB6, FB8, FB9: Ferrite_Bead_Small; L_Axial_L6.6mm_D2.7mm_P10.16mm_Horizontal_Vishay_IM-2
FB7: L_Axial_L6.6mm_D2.7mm_P10.16mm_Horizontal_Vishay_IM-2
J4: Chroma Disconnect; PinHeader_1x02_P2.54mm_Vertical
Q1: 2sc1959; TO-92_Inline_Wide
Q2: 2SC1815; TO-92_Inline_Wide
R2, R4: 330; R_Axial_DIN0207_L6.3mm_D2.5mm_P7.62mm_Horizontal
R3, R5: 560; R_Axial_DIN0207_L6.3mm_D2.5mm_P7.62mm_Horizontal
R16: 240; R_Axial_DIN0207_L6.3mm_D2.5mm_P7.62mm_Horizontal
R17: 510; R_Axial_DIN0207_L6.3mm_D2.5mm_P7.62mm_Horizontal
R18: 1K; R_Axial_DIN0207_L6.3mm_D2.5mm_P7.62mm_Horizontal
R19: 1.8K; R_Axial_DIN0207_L6.3mm_D2.5mm_P7.62mm_Horizontal
R20: 2.7K; R_Axial_DIN0207_L6.3mm_D2.5mm_P7.62mm_Horizontal
R21: 470; R_Axial_DIN0207_L6.3mm_D2.5mm_P7.62mm_Horizontal
R22: 270; R_Axial_DIN0207_L6.3mm_D2.5mm_P7.62mm_Horizontal
R36: 75; R_Axial_DIN0207_L6.3mm_D2.5mm_P7.62mm_Horizontal
RV1: 1K; Potentiometer_Trimmer_2x4.kicad_mod
U1: 7402; DIP-14_W7.62mm_Socket
U20: 6560-101; DIP-40_W15.24mm_Socket
Y1: Crystal 14.31818MHz; Crystal_HC18-U_Vertical

Connections:
+5V: C9.1, C37.1, FB7.1, FB8.1, R3.2, R5.2
AUDIOOUT: C11.2
BD0: U20.16 (D0)
BD1: U20.15 (D1)
BD2: U20.14 (D2)
BD3: U20.13 (D3)
BD4: U20.12 (D4)
BD5: U20.11 (D5)
BD6: U20.10 (D6)
BD7: U20.9 (D7)
CHROMA: C40.2, FB9.2, U20.2 (CHROMA)
GND: C6.2, C7.2, C8.2, C9.2, C10.2, C37.2, C38.2, R20.2, R21.2, R22.2, RV1.3
LPEN: U20.37 (LPEN)
LUMA: R16.2, U20.3 (LUMA/SYNC)
unnamed: C2.1, C3.2, Y1.2
unnamed: C2.2, C3.1, R4.1, U1.4, U1.11, U1.12
unnamed: C5.2, J4.2
unnamed: C6.1, FB7.2, U20.40 (VDD)
unnamed: C10.1, Q2.3 (B), R18.1
unnamed: C11.1, Q2.1 (E), R21.1
unnamed: C8.1, C38.1, FB8.2, Q1.2 (C), Q2.2 (C), R17.1, R19.1
unnamed: C39.1, Q1.3 (B), R19.2, R20.1
unnamed: C5.1, C39.2, RV1.2
unnamed: C40.1, R36.2
unnamed: FB4.1, U20.38 (ϕ2)
unnamed: FB5.1, U20.39 (ϕ1)
unnamed: FB6.1, U20.35 (PO1)
unnamed: FB9.1, J4.1
unnamed: R2.1, R4.2, U1.1, U1.5, U1.6, U1.8, U1.9
unnamed: R2.2, U1.2, U1.3, Y1.1
unnamed: R16.1, R17.2, RV1.1
POTX: U20.17 (POTX)
POTY: U20.18 (POTY)
SVIDC: R36.1
VA0: U20.21 (A0)
VA1: U20.22 (A1)
VA2: U20.23 (A2)
VA3: U20.24 (A3)
VA4: U20.25 (A4)
VA5: U20.26 (A5)
VA6: U20.27 (A6)
VA7: U20.28 (A7)
VA8: U20.29 (A8)
VA9: U20.30 (A9)
VA10: U20.31 (A10)
VA11: U20.32 (A11)
VA12: U20.33 (A12)
VA13: U20.34 (A13)
VD8: U20.8 (D8)
VD9: U20.7 (D9)
VD10: U20.6 (D10)
VD11: U20.5 (D11)
VICAUDIO: C7.1, R18.2, U20.19 (VICAUDIO)
VICO1: FB5.2, R3.1, U1.10
VICO2: FB4.2, R5.1, U1.13
VICPO1: FB6.2
VIDEOOUT: Q1.1 (E), R22.1
VRW: U20.4 (R/~W)

Notes on the sheet:
AUDIO
CLOCK
VIDEO
