Commotari/vic2020_V2/(commit log)

2026-03-30 Rearrangements in the Schematic to move parts of the circuit to other main or subpages. Not finished.
    [Address_Selection.kicad_sch, Memory.kicad_sch, VIC2020DISPLAY.kicad_sch, VIC2020IO.kicad_sch, Vic2020mainboard.kicad_sch, vic2020cpu.kicad_sch, video_daughter_board_ntsc.kicad_sch]
2026-04-03 Added power supply circuit for 9V AC input
    [Address_Selection.kicad_sch, Memory.kicad_sch, Power_Supply.kicad_sch, VIC2020DISPLAY.kicad_sch, VIC2020IO.kicad_sch, Vic2020mainboard.kicad_sch, vic2020cpu.kicad_sch, video_daughter_board_ntsc.kicad_sch]
